NorthernWidget/ALog-BottleLogger2/README.md

# ALog-BottleLogger2
Arduino-based low-power field environmental data logging platform: hardware schematics and circuit board layouts
