NorthernWidget/ALog-BottleLogger2/PDF_Documents/Bottlelogger_V2_r1.xls

 | Component list |  | for imported PR99SE Designs only | <Parameter ProjectTitle not found>
 | Project: | <Parameter ProjectTitle not found> |  | PCB Assembly: | <Parameter AssemblyNr not found> | Sch. Drw. Nr: | 4415-0039
 | Project Number: | <Parameter PrjNr not found> |  | PCB Nr: | <Parameter PCBNr not found> | Sch. Rev: | 1
 | Used In: | <Parameter UsedIn not found> |  | PCB Type: | <Parameter PCBType not found> | Sch Type: | <Parameter DrawingType not found>
 | Filename: | Bottlelogger_V2.PrjPcb |  | Repl. For: | <Parameter ReplFor not found> | Build Nr: | <Parameter BuildNr not found>
 |  |  |  | PCB revision: | <Parameter PCBRev not found> | Author: | <Parameter DrawnBy not found>
 | Report Date/Time: | 2015-10-03 | 1:18:15 PM | Board Name: | <Parameter PCBName not found> | BOM Version: | <Parameter BOMVersion not found>
 | Print Date/Time: | 2015-10-14 | 7:54:47 |  |  | TPL Version: | V1.12 2015-03-09
Line | Part Designator | Schematic Part Value | Part Footprint | Part Library Reference | Vendor Part Description | Mfr. Part Number | Vendor Part Number | Part Mfr. | Vendor Name | Special Notes | Status | RoHS Status | Qty | Vendor Price | Price Mult.
1 | B1 | BR1225-1HC | BR1225/1HF2 | BATTERY | BATTERY LITH 12.5MM COIN W/LEGS | BR1225-1HC | P191-ND |  | DK |  |  | OK | 1 | 1.78 | 1
2 | C1, C2, C3A, C3B, C3C, C6, C9, C19, C22, C23, C24, C25, C27, C28, C30 | 0u1 | 0805N2 | CAPACITOR_N2_GND, CAPACITOR_N2_GND, CAPACITOR_N2_GND, CAPACITOR_N2_GND, CAPACITOR_N2_GND, CAPACITOR_N2_S, CAPACITOR_N2_S_GND, CAPACITOR_N2_GND, CAPACITOR_N2_GND, CAPACITOR_N2_GND, CAPACITOR_N2_GND, CAPACITOR_N2_GND, CAPACITOR_N2_GND, CAPACITOR_N2, CAPACITOR_N2_S_GND | CAP CER 0.1UF 50V 10% X7R 0805 | C0805C104K5RACTU | 399-1170-1-ND |  | DK |  |  | OK | 15 | 0.035 | 50
3 | C3 | 3n3 | 0805N2 | CAPACITOR_N2_GND | CAP CER 3300PF 50V 1% NP0 0805 | GRM2165C1H332FA01J | 490-8287-1-ND |  | DK |  |  | OK | 1 | 0.51 | 1
4 | C4, C5 | 2u2 | 0805N2 | CAPACITOR_N2_GND | CAP CER 2.2UF 10V 10% X7R 0805 | LMK212B7225KG-T | 587-1286-1-ND |  | DK |  |  | OK | 2 | 0.21 | 1
5 | C7, C8 | 18pF | 0805N2 | CAPACITOR_N2_GND | CAP CER 18PF 50V 5% NP0 0805 | 500R15N180JV4T | 709-1171-1-ND |  | DK |  |  | OK | 2 | 0.13 | 1
6 | C10 | 10uF | RB.1/.2 | CAPACITOR POL_N2_GND | CAP ALUM 10UF 20% 16V RADIAL | EEA-GA1C100H | P15787CT-ND |  | DK |  |  | OK | 1 | 0.47 | 1
7 | C11, C12 | 1uF | 0805N2 | CAPACITOR_N2_GND | CAP CER 1UF 10V X7R 0805 | 0805ZC105KAT2A | 478-1405-1-ND |  | DK |  |  | OK | 2 | 0.08 | 10
8 | C13, C14, C15, C16, C17, C18, C21, C29 | 10n | 0805N2 | CAPACITOR_N2_GND, CAPACITOR_N2_GND, CAPACITOR_N2_GND, CAPACITOR_N2_GND, CAPACITOR_N2_GND, CAPACITOR_N2_GND, CAPACITOR_N2_S_GND, CAPACITOR_N2 | CAP CER 10000PF 50V 10% X7R 0805 | GRM216R71H103KA01D | 490-1664-1-ND |  | DK |  |  | OK | 8 | 0.023, 0.023, 0.023, 0.023, 0.023, 0.023, 0.035, 0.023 | 50
9 | C20 | 4u7, 10V, T | 3216 | CAPACITOR POL_N2_GND | CAP TANT 4.7UF 10V 10% 1206 | T491A475K010AT | 399-3696-1-ND |  | DK |  |  | OK | 1 | 0.46 | 1
10 | C26 | 4u7, T | 3216 | CAPACITOR POL_N2 | CAP TANTALUM 4.7UF 6.3V 10% SMD | B45196H1475K109 | 495-2177-1-ND |  | DK |  |  | OK | 1
11 | D1 | SF1 | LED-1206 | LED_SMD_GRN | LED GREEN CLEAR 1206 SMD | LTST-C150KGKT | 160-1404-1-ND |  | DK |  |  | OK | 1 | 0.52 | 1
12 | D2 | TX | LED-1206 | LED_SMD_RED | LED RED CLEAR 1206 SMD | LTST-C150CKT | 160-1167-1-ND |  | DK |  |  | OK | 1 | 0.52 | 1
13 | D3 | RX | LED-1206 | LED_SMD_YEL | LED RED ORANGE CLEAR 1206 SMD | LTST-C150EKT | 160-1168-6-ND |  | DK |  |  | OK | 1 | 0.48 | 1
14 | D4, D6, D7 | BAT54C-7-F | SOT-23 | BAV74-SOT-23 | DIODE ARRAY SCHOTTKY 30V SOT23-3 | BAT54C-7-F | BAT54C-FDICT-ND |  | DK |  |  | OK | 3 | 0.27 | 1
15 | D5 | TZ5.6V | SMB-DIODE | DIODE ZENER_GND_N2 | DIODE ZENER 3W 5.6V SMB | 1SMB5919BT3G | 1SMB5919BT3GOSCT-ND |  | DK |  |  | OK | 1
16 | F1 | microSMD050 | 1210N2 | VARISTOR | POLYSWITCH 0.50A RESET FUSE SMD | MICROSMD050F-2 | MICROSMD050FCT-ND |  | DK |  |  | OK | 1 | 0.575 | 10
17 | F2 | MINIASMDC020F-2 | 1812R2 | VARISTOR | POLYSWITCH 0.20A RESET FUSE SMD | MINIASMDC020F-2 | MINIASMDC020F-2CT-ND |  | DK |  |  | OK | 1 | 0.57500 | 10
18 | FB1 | TBD | 1206N2 | FERRITE BEAD |  |  |  |  |  |  |  |  | 1
19 | H1, H2 | CON8 | MOLEX-6373-8 | CON8 | CONN TERM BLOCK 2.54MM 8POS PCB | OSTVN08A150 | ED10566-ND |  | DK |  |  | OK | 2 | 2.63 | 1
20 | H3 | CON4 | MOLEX-6373-4 | CON4 | CONN TERM BLOCK 2.54MM 4POS PCB | OSTVN04A150 | ED10563-ND |  | DK |  |  | OK | 1 | 1.41 | 1
21 | J1 | 61729-0010BLF | USB-B RECEPTICAL | USB-B JACK_FCI_61729-0010BLF | Connector Receptacle USB TypeB | 61729-0010BLF | 609-1039-ND |  | DK |  |  | OK | 1 | 1.23 | 1
22 | J2 | PJ-102A | PCOAX-PJ-102A | DC-JACK | CONN JACK POWER 2.1MM PCB | PJ-102A | CP-102A-ND |  | DK |  |  | OK | 1 | 1.34 | 1
23 | J2B | 1727010 | MKDS-2-3.81 | CON2 | TERM BLOCK 2POS 3.81MM PCB GRN | 1727010 | 277-1947-ND |  | DK |  |  | OK | 1 | 1.50 | 1
24 | J3 | 22-28-4043 | MOLEX-6373-4 | CON4 | CONN HEADER 4POS .100 VERT GOLD | 22-28-4043 | WM6504-ND |  | DK |  |  | OK | 1
25 | J4 | OSTVN03A150 | MOLEX-6373-3 | CON3 | CONN TERM BLOCK 2.54MM 3POS PCB | OSTVN03A150 | ED10562-ND |  | DK |  |  | OK | 1 | 1.06 | 1
26 | J5 | CON6 | MOLEX-6373-6 | CON6 | CONN TERM BLOCK 2.54MM 6POS PCB | OSTVN06A150 | ED10565-ND |  | DK |  |  | OK | 1 | 1.97 | 1
27 | J6 | PPPC061LFBN-RC | HEADER-6X1 | CON6 | Connector Header 6 Position 0.100 | PPPC061LFBN-RC | S7039-ND |  | DK |  |  | OK | 1 | 0.94 | 1
28 | J7 | CON2 | HEADER-2X1 | CON2 | CONN HEADER 2POS .100" SGL GOLD | TSW-102-07-L-S | SAM1031-02-ND |  | DK |  |  | OK | 1 | 0.95 | 1
29 | JP1 | ISP | HEADER-8X2 | HEADER 8X2 | CONN HEADER 16POS .100" DL GOLD | TSW-108-07-L-D | SAM1030-08-ND |  | DK |  |  | OK | 1 | 2.86 | 1
30 | JP2, JP3 | HEADER 4X2 | HEADER-4X2 | HEADER 4X2 |  |  |  |  |  |  |  |  | 2
31 | JP4 | HEADER 5X2 | HEADER-5X2 | HEADER 5X2 | CONN HEADER 10POS .100" DL GOLD | TSW-105-07-L-D | SAM1030-05-ND |  | DK |  |  | OK | 1 | 2.37 | 1
32 | JP5 | VBE | HEADER-2X1 | HEADER 2L | CONN HEADER 2POS .100" SGL GOLD | TSW-102-07-L-S | SAM1031-02-ND |  | DK |  |  | OK | 1 | 0.95 | 1
33 | JP6 | TSW-102-07-L-S | HEADER-2X1 | HEADER 2L | CONN HEADER 2POS .100" SGL GOLD | TSW-102-07-L-S | SAM1031-02-ND |  | DK |  |  | OK | 1 | 0.95 | 1
34 | LOGO1 | ALOG LOGO | ALOG_LOGO_V1_SMALL | BARCODE_DY_10MM | BAR CODE FIELD - NOT A PART | N/A | N/A |  | N/A |  | DNP | N/A | 1 | N/A | N/A
35 | LOGO2 | NORTHERN WIDGET LOGO | NWLOGO | BARCODE_DY_10MM | BAR CODE FIELD - NOT A PART | N/A | N/A |  | N/A |  | DNP | N/A | 1 | N/A | N/A
36 | OSHW1 | OSHW_FILLX200 | OSHW_FILLX200_NOTEXT_N1 | BARCODE_DY_10MM | BAR CODE FIELD - NOT A PART | N/A | N/A |  | N/A |  | DNP | N/A | 1 | N/A | N/A
37 | Q1, Q2, Q5 | FDN360P | SOT-23 | MOSF-P-SOT-23_R1 | MOSFET P-CH 30V 2A SSOT3 | FDN360P | FDN360PCT-ND |  | DK |  |  | OK | 3 | 0.6020 | 10
38 | Q3, Q4 | BSS138 | SOT-23 | MOSF-N-SOT-23 | MOSFET N-CH 50V 200MA SOT23-3 | BSS138-7-F | BSS138-FDICT-ND |  | DK |  |  | OK | 2 | 0.47 | 1
39 | R1, R2, R3, R4, R5, R6, R19, R20, R21, R22, R23, R24, R30, R31 | 10K0 | 0805N2 | WID_SHRT_GND, WID_SHRT_GND, WID_SHRT_GND, WID_SHRT_GND, WID_SHRT_GND, WID_SHRT_GND, WID_SHRT, WID_SHRT, WID_SHRT, WID_SHRT, WID_SHRT, WID_SHRT, WID_SHRT, WID_SHRT_GND | RES SMD 10K OHM 1% 1/8W 0805 | ERJ-6ENF1002V | P10.0KCCT-ND |  | DK |  |  | OK | 14 | 0.14 | 1
40 | R7, R8, R26, R27, R34 | 3K | 0805N2 | WID_SHRT | RES SMD 3K OHM 5% 1/8W 0805 | RC0805JR-073KL | 311-3.0KARCT-ND |  | DK |  |  | OK | 5 | 0.14 | 1
41 | R9, R12, R13, R43, R44, R49 | 1K | 0805N2 | WID_SHRT | RES SMD 1K OHM 5% 1/8W 0805 | RC0805JR-071KL | 311-1.0KARCT-ND |  | DK |  |  | OK | 6 | 0.14 | 1
42 | R10, R11, R17, R18, R33, R42, R51, R55, R56, R57 | 330R | 0805N2 | WID_SHRT | RES SMD 330 OHM 5% 1/8W 0805 | RC0805JR-07330RL | 311-330ARCT-ND |  | DK |  |  | OK | 10 | 0.14 | 1
43 | R14, R25, R48 | 10K | 0805N2 | WID_SHRT | RES SMD 10K OHM 5% 1/8W 0805 | RC0805JR-0710KL | 311-10KARCT-ND |  | DK |  |  | OK | 3 | 0.14 | 1
44 | R15, R53 | 220R | 0805N2 | WID_SHRT | RES SMD 220 OHM 5% 1/8W 0805 | RC0805JR-07220RL | 311-220ARCT-ND |  | DK |  |  | OK | 2 | 0.14 | 1
45 | R16 | 470K | 0805N2 | WID_SHRT | RES SMD 470K OHM 5% 1/8W 0805 | RC0805JR-07470KL | 311-470KARCT-ND |  | DK |  |  | OK | 1 | 0.14 | 1
46 | R28, R37, R38, R39, R41, R47 | 100K | 0805N2 | WIDERSTAND, WIDERSTAND, WIDERSTAND, WID_SHRT_GND, WID_SHRT_GND, WID_SHRT | RES SMD 100K OHM 5% 1/8W 0805 | ERJ-6GEYJ104V | P100KACT-ND |  | DK |  |  | OK | 6 | 0.14 | 1
47 | R29, R45 | 100R | 0805N2 | WIDERSTAND | RES 100 OHM 1/8W 5% 0805 SMD | ERJ-6GEYJ101V | P100ACT-ND |  | DK |  |  | OK | 2 | 0.14 | 1
48 | R32, R50 | 10R | 0805N2 | WID_SHRT | RES SMD 10 OHM 5% 0.4W 0805 | ESR10EZPJ100 | RHM10KCT-ND |  | DK |  |  | OK | 2 | 0.14 | 1
49 | R35 | 510R, 1W | 2512R2 | WID_SHRT | RES SMD 510 OHM 5% 1W 2512 | RMCF2512JT510R | RMCF2512JT510RCT-ND |  | DK |  |  | OK | 1 | 0.63 | 1
50 | R36 | 200K | 0805N2 | WID_SHRT_GND | RES SMD 200K OHM 5% 1/8W 0805 | RC0805JR-07200KL | 311-200KARCT-ND |  | DK |  |  | OK | 1 | 0.14 | 1
51 | R40 | 510R | 0805N2 | WID_SHRT | RES SMD 510 OHM 5% 1/8W 0805 | RC0805JR-07510RL | 311-510ARCT-ND |  | DK |  |  | OK | 1 | 0.14 | 1
52 | R46 | 120R | 0805N2 | WID_SHRT | RES SMD 120 OHM 5% 1/8W 0805 | RC0805JR-07120RL | 311-120ARCT-ND |  | DK |  |  | OK | 1 | 0.14 | 1
53 | R52 | 3K(DNP) | 0805N2 | WID_SHRT | RES SMD 3K OHM 5% 1/8W 0805 | RC0805JR-073KL | 311-3.0KARCT-ND |  | DK |  |  | OK | 1 | 0.14 | 1
54 | R54 | 4K7 | 0805N2 | WID_SHRT | RES SMD 4.7K OHM 5% 1/8W 0805 | ERJ-6GEYJ472V | P4.7KACT-ND |  | DK |  |  | OK | 1 | 0.14 | 1
55 | SD1 | 2041021-4 | TE_2041021-4_SDCARD | 3M_SD-RSMT-2-MQ-WF_N2 | CONN SD CARD PUSH-PULL R/A SMD | 2041021-4 | A101492CT-ND |  | DK |  |  | OK | 1 | 4.16 | 1
56 | SG1 | 2051-09-SM-RPLF | 1812 | SPARKGAP | GDT 90V 30% 2KA SURFACE MOUNT | 2051-09-SM-RPLF | 2051-09-SM-RPLFCT-ND |  | DK |  |  | OK | 1 | 1.10 | 1
57 | SN1 | SER. NUM. | STATIC-0.25" | BARCODE_DY_10MM | BAR CODE FIELD - NOT A PART | N/A | N/A |  | N/A |  | DNP | N/A | 1 | N/A | N/A
58 | SP1 | VREF SEL | SOLDERPAD-2WAY | SOLDER-PAD 2WAY |  |  |  |  |  |  |  |  | 1
59 | SW1 | MAN LOG | SWITCH_EVQPE1_PANASONIC | SW PUSHBUTTON | SWITCH TACTILE SPST-NO 0.05A 12V | EVQ-PE104K | P13593SCT-ND |  | DK |  |  | OK | 1 | 1.03 | 1
60 | SW2 | RESET | SWITCH_EVQPE1_PANASONIC | SW PUSHBUTTON | SWITCH TACTILE SPST-NO 0.05A 12V | EVQ-PE104K | P13593SCT-ND |  | DK |  |  | OK | 1 | 1.03 | 1
61 | TP1 | 32KHZ | TESTPOINT-2 | TESTPOINT | PCB Primitive - Not a part | N/A | N/A |  | N/A |  |  | N/A | 1 | N/A | N/A
62 | TP2 | 3.3V | TESTPOINT-2 | TESTPOINT | PCB Primitive - Not a part | N/A | N/A |  | N/A |  |  | N/A | 1 | N/A | N/A
63 | TP3 | VUSB | TESTPOINT-2 | TESTPOINT | PCB Primitive - Not a part | N/A | N/A |  | N/A |  |  | N/A | 1 | N/A | N/A
64 | TP4 | CSD | TESTPOINT-2 | TESTPOINT | PCB Primitive - Not a part | N/A | N/A |  | N/A |  |  | N/A | 1 | N/A | N/A
65 | TVS1 | USBLC6-2 | SOT-23-6 | USBLC6-2 | IC ESD PROTECTION FOR HS SOT-23-6 | USBLC6-2SC6Y | 497-11882-1-ND |  | DK | DNP |  | OK | 1 | 1.046 | 10
66 | TVS2, TVS3 | MMBZ5V6ALT1 | SOT-23 | MMBZ5V6ALT1G | TVS ZENER DUAL 24W CA 5.6V SOT23 | MMBZ5V6ALT1G | MMBZ5V6ALT1GOSCT-ND |  | DK |  |  | OK | 2 | , 0.32
67 | U1 | ATMEGA1284P-AUR | TQFP-44-10X10X1_0.8_SOT376-1 | ATMEGA1284P_TQFP | IC MCU 8BIT 128KB FLASH 44TQFP | ATMEGA1284P-AUR | ATMEGA1284P-AURCT-ND |  | DK |  |  | OK | 1 | 11.50 | 1
68 | U2, U3 | LP2985-33DBVR | SOT-23-5 | LP2985 | IC REG LDO 3.3V 0.15A SOT23-5 | LP2985-33DBVR | 296-18476-1-ND |  | DK |  |  | OK | 2 | 0.8 | 1
69 | U4 | CD4050BPWR | TSSOP-16R2_4.5MM | MC14050B_N1 | IC BUFF/CONVERTER HEX 16TSSOP | CD4050BPWR | 296-31504-1-ND |  | DK |  |  | OK | 1 | 0.59 | 1
70 | U5 | FT232RL | SSOP-28 | FT232RL_M2_R1 | IC USB FS SERIAL UART 28-SSOP | FT232RL-REEL | 768-1007-1-ND |  | DK |  |  | OK | 1 | 6.03 | 1
71 | U6 | DS3231 | SOL-16R2 | DS3231 | IC RTC CLK/CALENDAR I2C 16-SOIC | DS3231SN#T&R | DS3231SN#T&RCT-ND |  | DK |  |  | OK | 1 | 13.37 | 1
72 | U7 | LTC4412 | SOT-23-6 | LTC4412 | IC OR CTRLR SRC SELECT TSOT23-6 | LTC4412ES6#TRMPBF | LTC4412ES6#TRMPBFCT-ND |  | DK |  |  | OK | 1 | 4.26 | 1
73 | U8 | SN74LVC1G125DBVR | SOT-23-5 | 74LVC1G125 | IC BUS BUFF TRI-ST N-INV SOT23-5 | SN74LVC1G125DBVR | 296-11603-1-ND |  | DK |  |  | OK | 1 | 0.52 | 1
74 | U9, U10 | SN74AHC1G14DBVR | SOT-23-5 | SN74AHC1G14 | IC SCHMITT-TRG INV GATE SOT23-5 | SN74AHC1G14DBVR | 296-1092-1-ND |  | DK |  |  | OK | 2 | 0.66 | 1
75 | U11 | SN74LVC1G126DBVR | SOT-23-5 | 74LVC1G126N1 | IC BUS BUFF TRI-ST N-INV SOT23-5 | SN74LVC1G126DBVR | 296-11605-1-ND |  | DK |  |  | OK | 1 | 0.52 | 1
76 | U12 | LTC1482CS8 | SO-8 | LTC1482_SM | IC TXRX RS485 LOWPWR 8-SOIC | LTC1482CS8#PBF | LTC1482CS8#PBF-ND |  | DK |  |  | OK | 1 | 4.46 | 1
77 | U14 | TMP101 | SOT-23-6 | TMP101 | IC TEMP SENSOR DIGITAL SOT-23-6 | TMP101NA/250 | 296-12750-1-ND |  | DK |  |  | OK | 1 | 3.66 | 100
78 | U15 | LTC1669 | MSOP-8 | LTC1669_MSOP-8 | IC DAC 10BIT R-R I2C 8-MSOP | LTC1669CMS8#PBF | LTC1669CMS8#PBF-ND |  | DK |  |  | OK | 1 | 4.72 | 1
79 | U16, U21 | SN74LVC1G08DBVR | SOT-23-5 | 74LVC1G08 | IC GATE AND 1CH 2-INP SOT-23-5 | SN74LVC1G08DBVR | 296-11601-1-ND |  | DK |  |  | OK | 2 | 0.66 | 1
80 | U17, U23 | SN74LVC1G3157 | SOT-23-6 | SN74LVC1G3157 | IC SWITCH SPDT SOT23-6 | SN74LVC1G3157DBVR | 296-14908-1-ND |  | DK |  |  | OK | 2 | 0.52 | 1
81 | U18 | LM4132AMF-3.0/NOPB | SOT-23-5 | LM4130-SOT23-5 | IC VREF SERIES 3V SOT23-5 | LM4132AMF-3.0/NOPB | LM4132AMF-3.0/NOPBCT-ND |  | DK |  |  | OK | 1 | 4.38 | 1
82 | U19 | M24M02-DRMN6TP | SO-8 | AT24C1024 | IC EEPROM 2MBIT 1MHZ 8SO | M24M02-DRMN6TP | 497-11600-1-ND |  | DK |  |  | OK | 1 | 6.26 | 1
83 | U20, U22 | 74LVC4066PW,118 | TSSOP-14N2 | MM74HC4016 | IC SWITCH QUAD SPST 14TSSOP | 74LVC4066PW,118 | 568-9989-1-ND |  | DK |  |  | OK | 2 | 1.11 | 1
84 | Y1 | 16MHZ | CM309S | CTS-XTAL_N2 | Crystals 16MHz 18pF PLASTIC SMD | CM309E-16.000MABJ-UT | 695-CM309E-16-U | ? | Mouser |  |  | OK | 1 | 1.23 | 1
85 | ZD1 | SMAJ4737A-TP | SMA-DIODE | DIODE ZENER | DIODE ZENER 7.5V 1W DO214AC | SMAJ4737A-TP | SMAJ4737A-TPMSCT-ND |  | DK |  |  | OK | 1 | 0.66 | 1
86
