NorthernWidget/ALog-BottleLogger2/PDF_Documents/BL1284P_Schematics.pdf

1 | 2 | 3 | 4 | 5 | 6

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
Unless otherwise specified, all values are as follows: resistor values are in Ohms, i.e. 0R47, 5R6, 220, 5K6, 22K capacitor values are in Microfarads, i.e. 220p, 0u1, 2u2, 33 inductor values are in Microhenries, i.e. 0u22, 5u6, 68, 2m2

The ALog BottleLogger 2.0 by Gerhard
Oberforcher and modified from the original
design by Andrew D. Wickert and Northern Widget LLC, is licensed under a Creative Commons Attribution-ShareAlike 3.0 Unported License

15027
ADT/GJO

# BOTTLE LOGGER V2.0.0

1 | 4415-0039

10-Nov-2015

Logger100.prj

Title

Size: | Drw. Nr

File:

Rev:

Sheet of

A3

Drw. Type: | Prj. Nr

Scale:

Date | Name
Drawn
Modified
Checked
Change | Change | Date | Name
Notification Nr. Index
PCB Nr. | 6-0039
Used in | Repl.for
Prototype | Production

PCB Name: Bottle Logger Board V2.0.0

PCB Type:

Requires TGL-017 Font

Build No.

BOM Done?

Name
Logger100PR.sch

Name
Logger100_IO.sch

x

FR4 2L 2LL 2SM 0.062 | EL | FIELD DATA LOGGING | BOTTLE LOGGER V1

PCB SCHEMATIC

1

YES

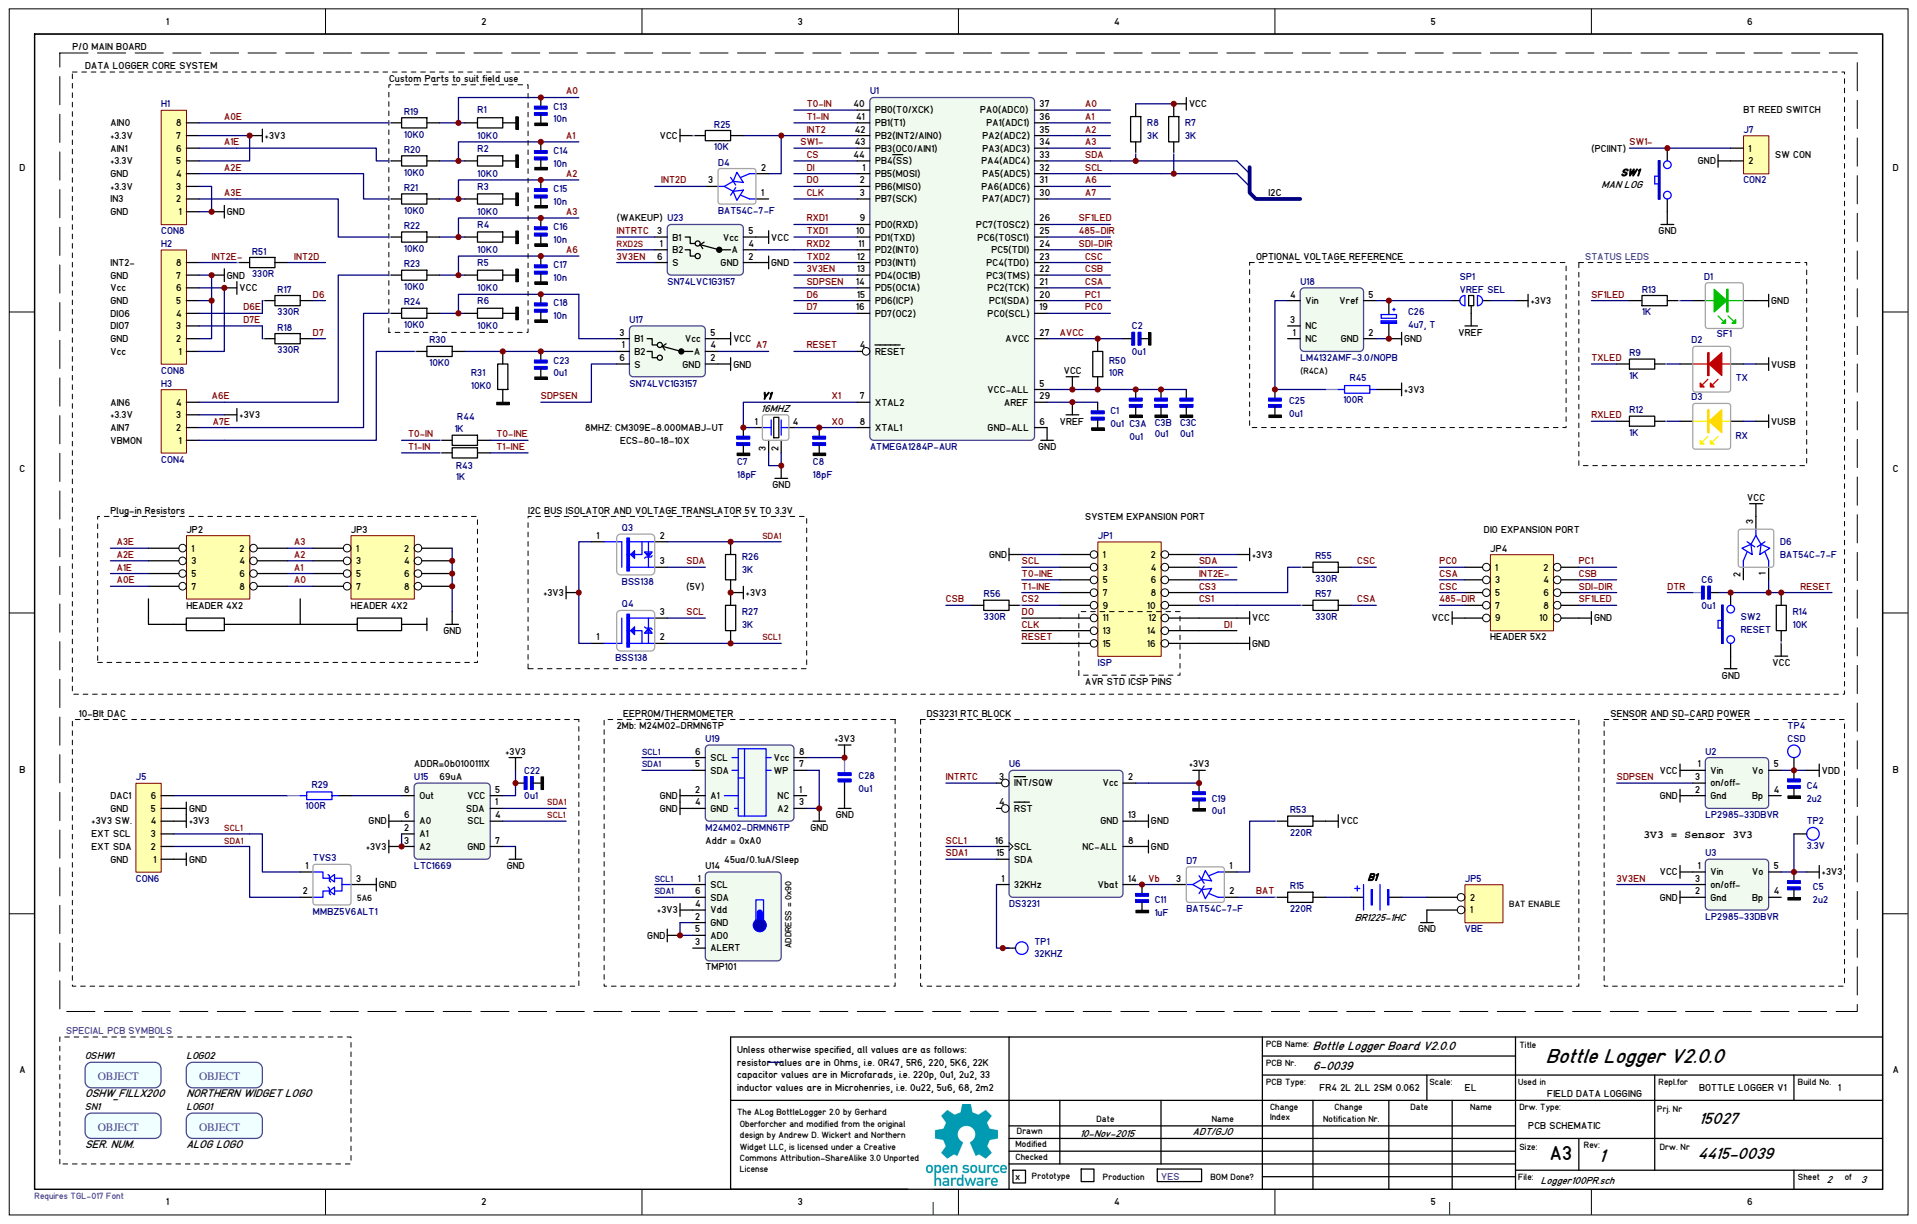
[picture p1: page 2]

P/O MAIN BOARD
DATA LOGGER CORE SYSTEM

Custom Parts to suit field use

I2C BUS ISOLATOR AND VOLTAGE TRANSLATOR 5V TO 3.3V

ISP
AVR STD ICSP PINS

SENSOR AND SD-CARD POWER

PCB Name: Bottle Logger Board V2.0.0

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

The ALog BottleLogger 2.0 by Gerhard
Oberforcher and modified from the original

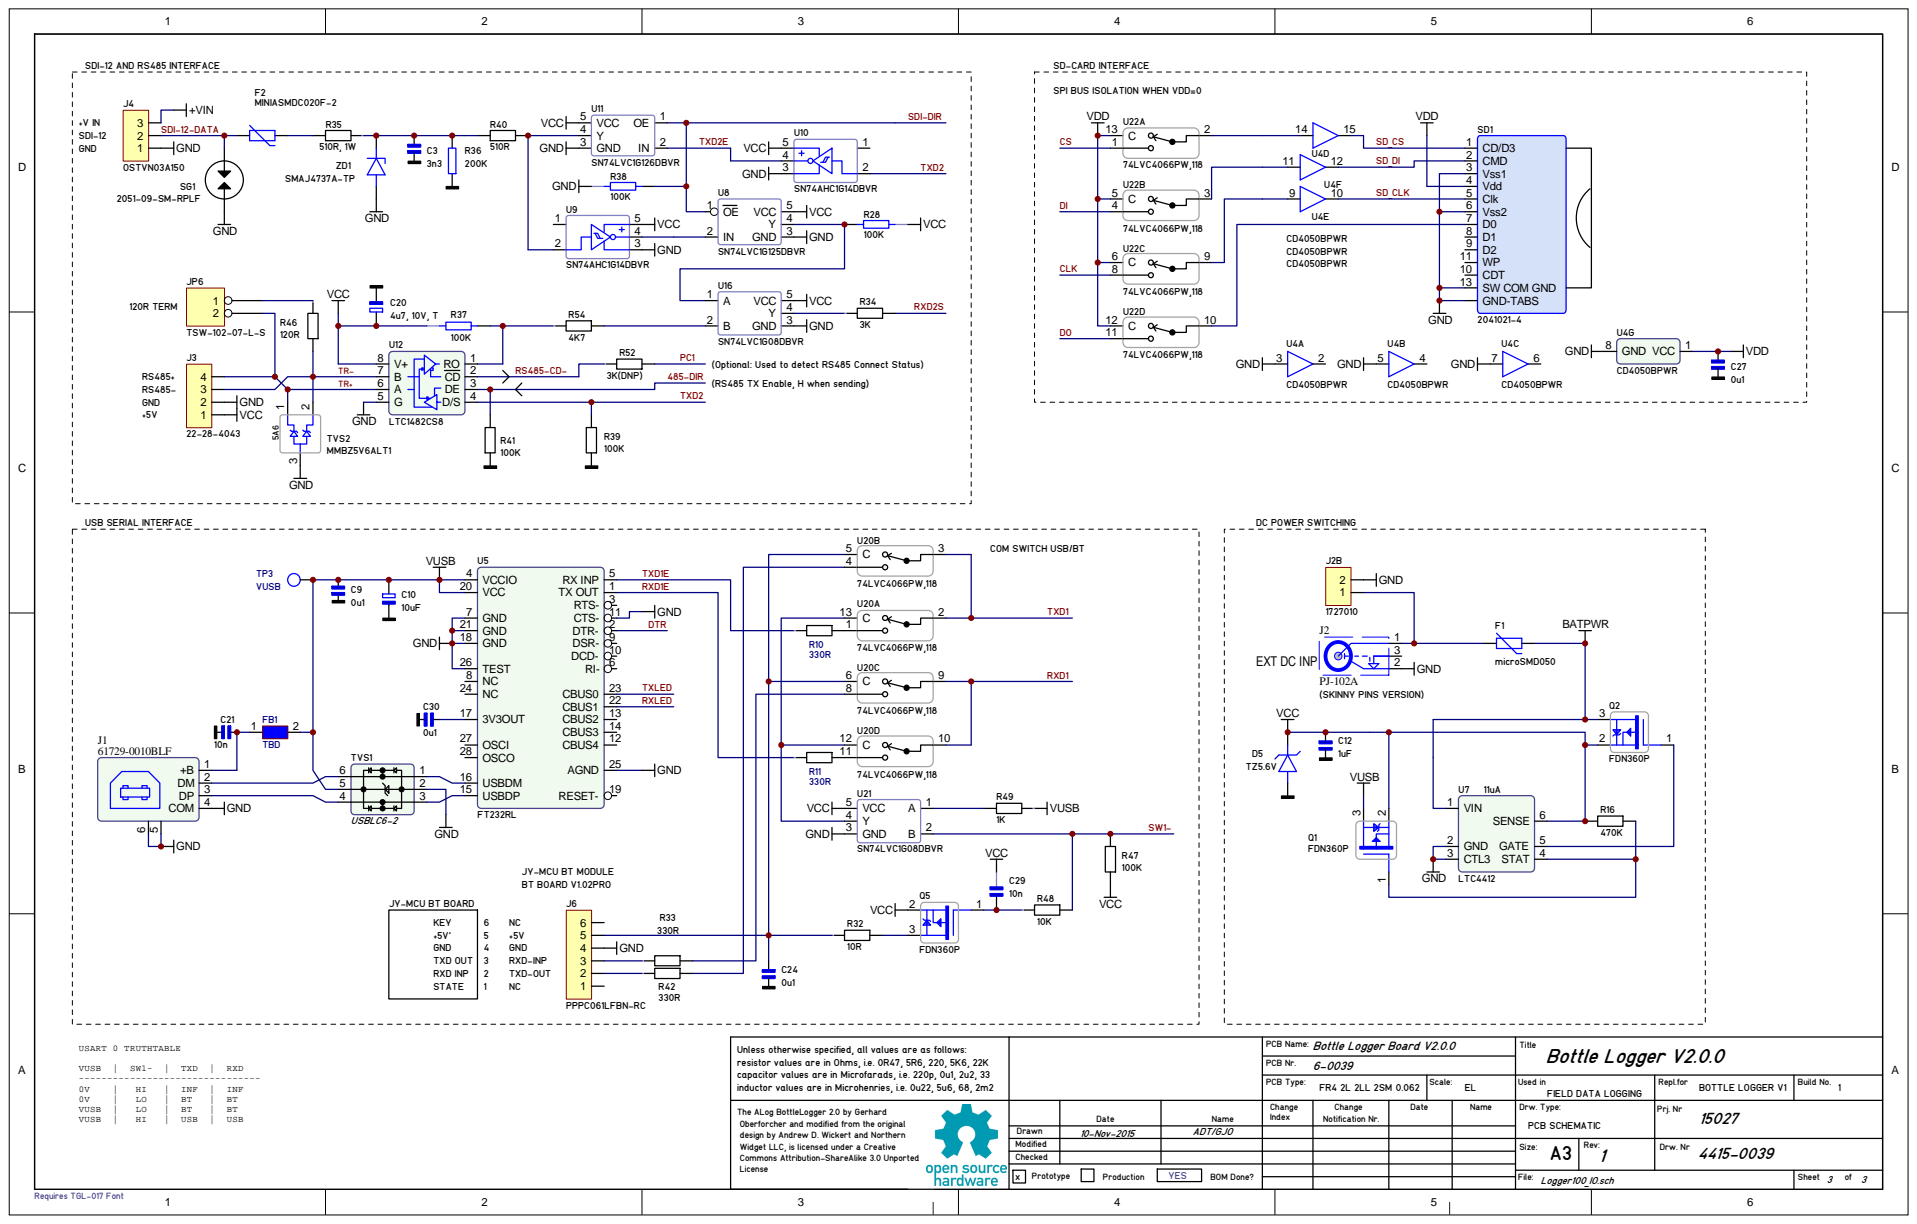
[picture p2: page 3]

COM SWITCH USB/BT

JY-MCU BT MODULE
BT BOARD V1.02PRO

JY-MCU BT BOARD

PCB Name: Bottle Logger Board V2.0.0

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

The ALog BottleLogger 2.0 by Gerhard
Oberforcher and modified from the original
