NorthernWidget/ALog-BottleLogger2/PDF_Documents/BL1284P_Bottom Assembly Drawing.pdf

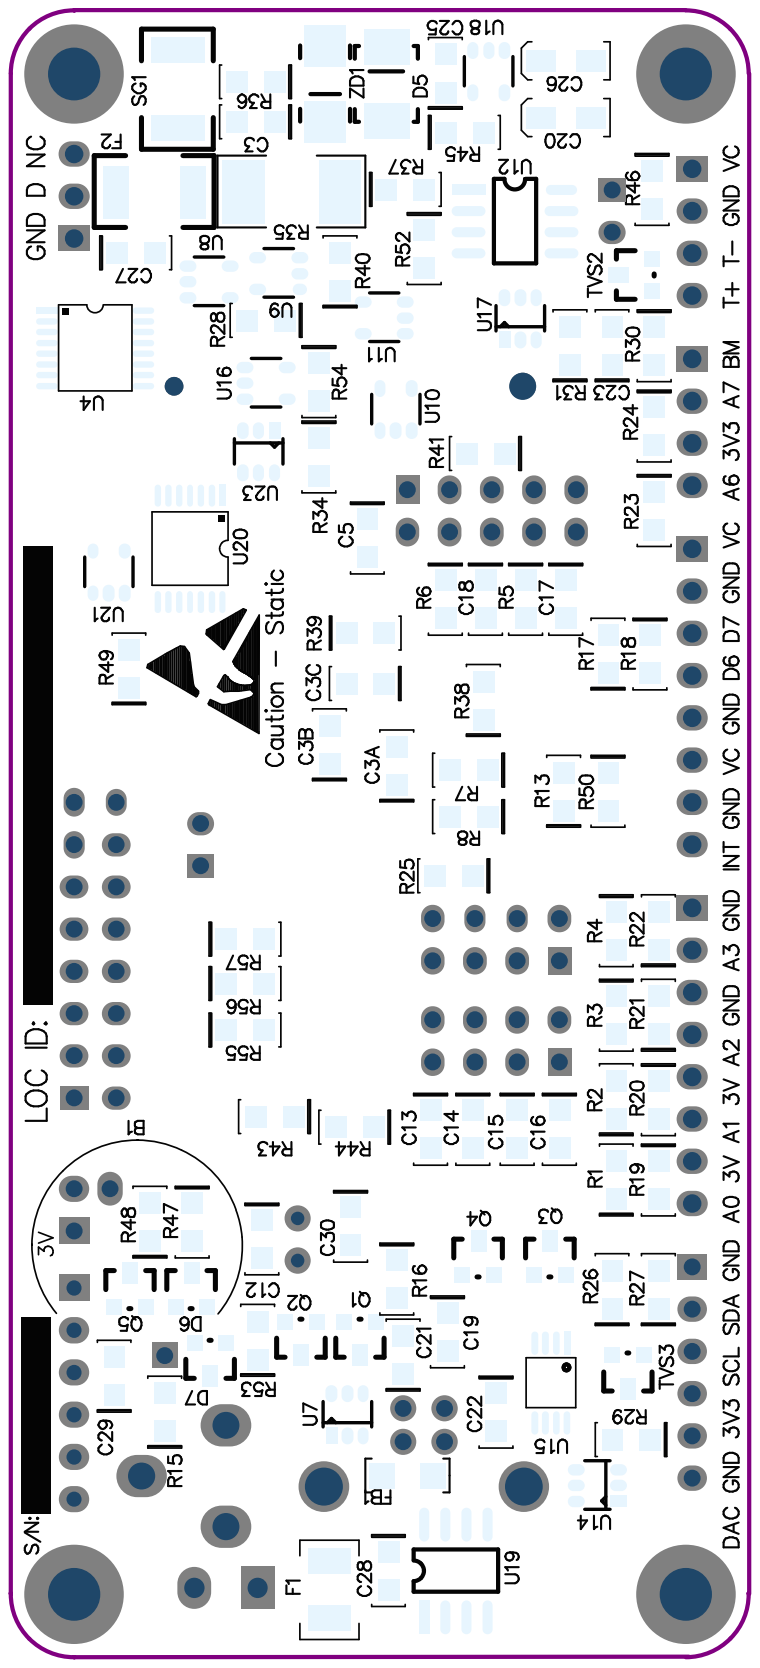
[picture p3: page 1]
