NorthernWidget/ALog-BottleLogger2/PDF_Documents/BL1284P_Top Assembly Drawing.pdf

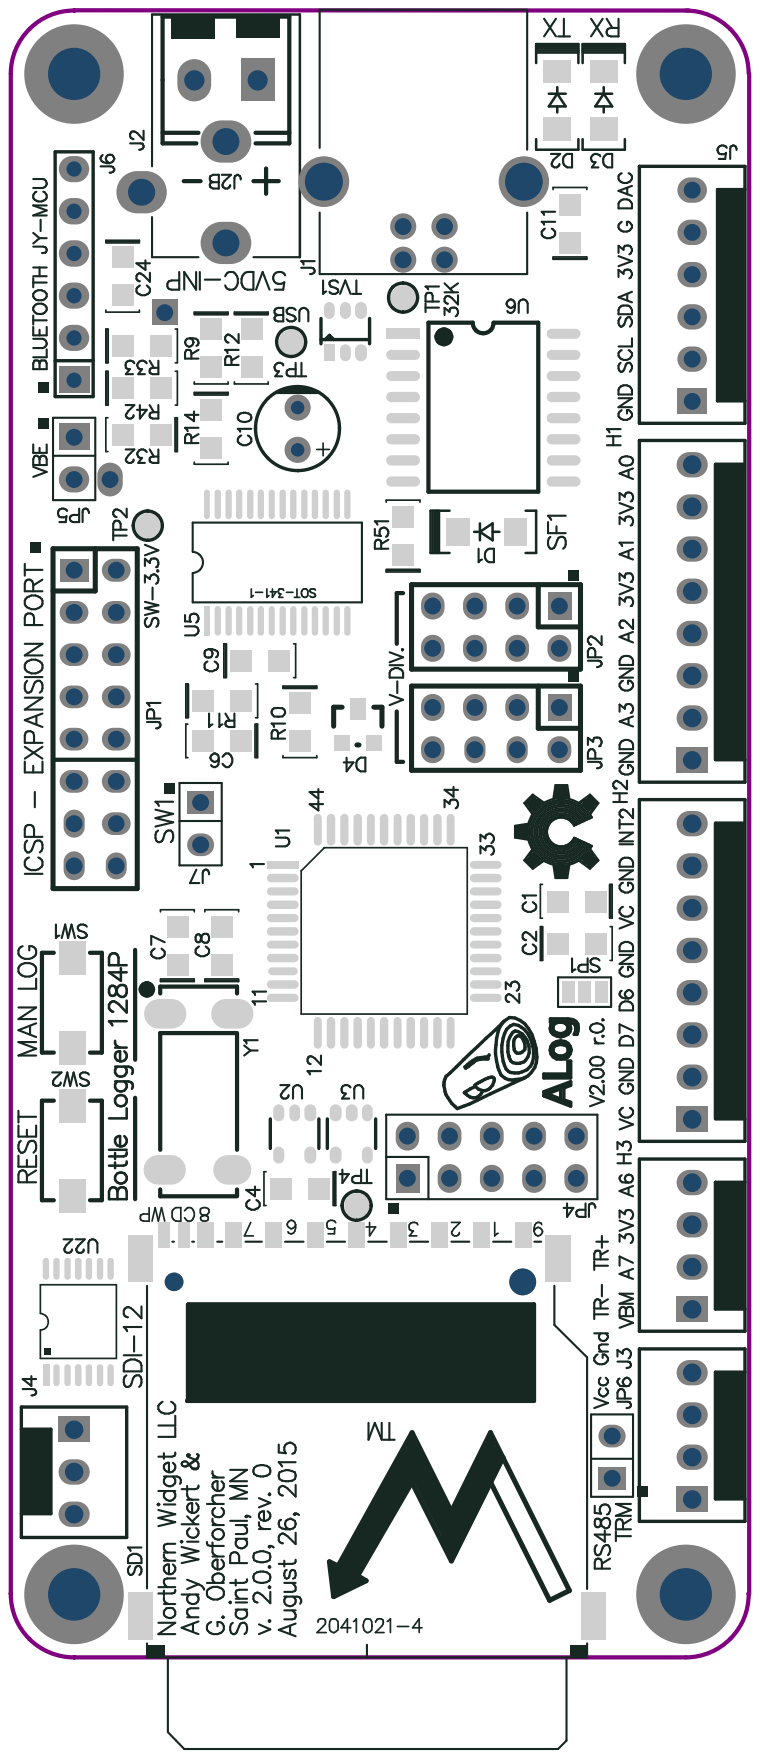
[picture p4: page 1]
