NorthernWidget/ALog-BottleLogger2/PDF_Documents/BL1284P_Composite_Layout.pdf

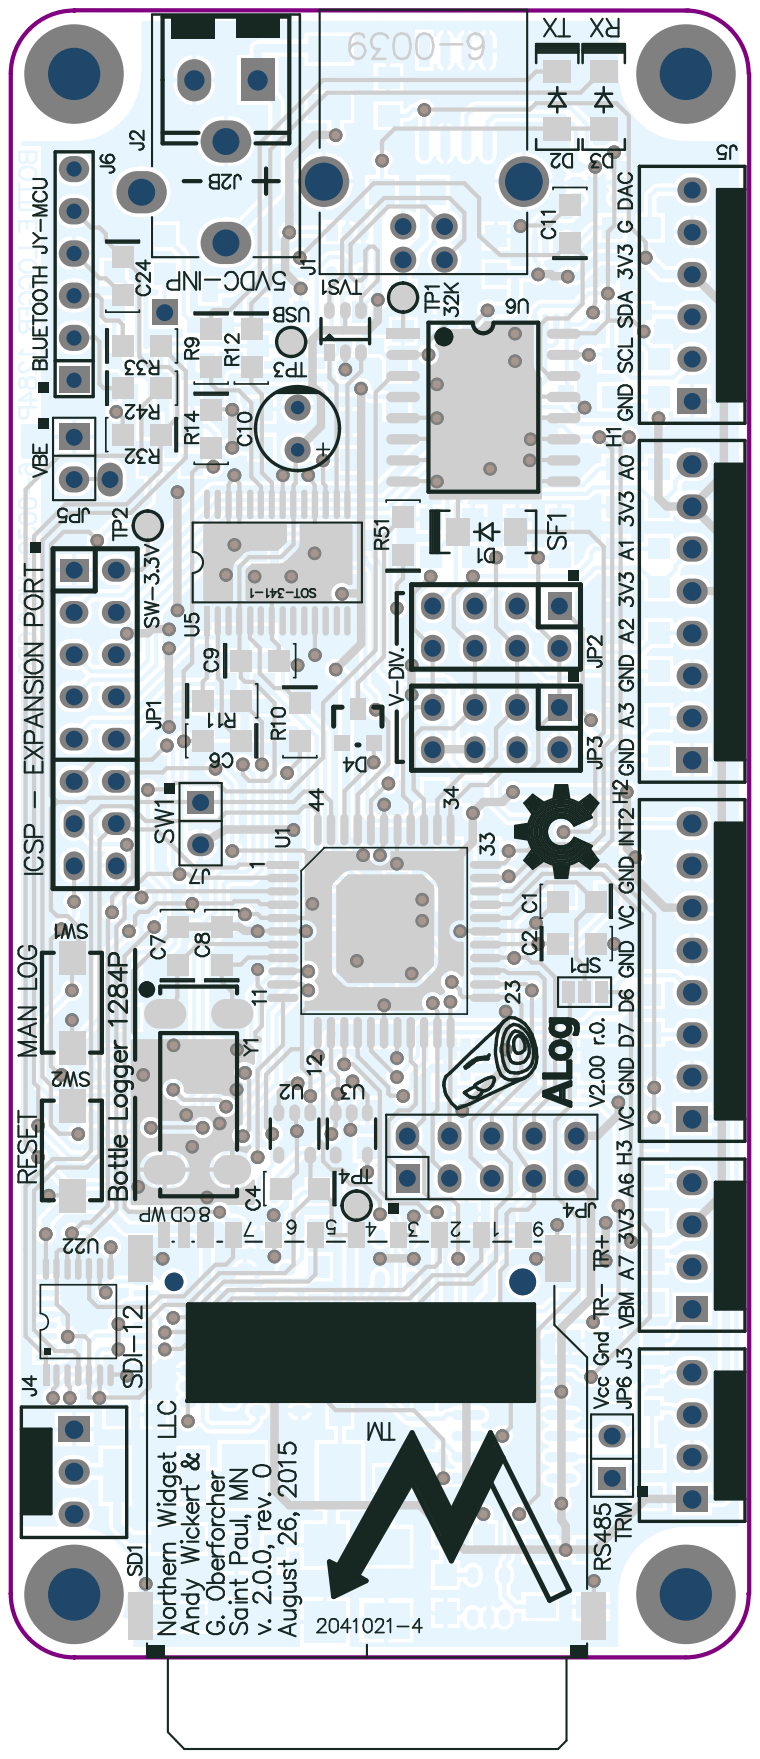
[picture p5: page 1]
