NorthernWidget/ALog-BottleLogger2/(list of files, drawings)

Other design files:
BL1284P_DataLogger_V2.00/Bottlelogger_V2/Assembly/logger100.pcb
BL1284P_DataLogger_V2.00/Bottlelogger_V2/logger100.pcb
