NorthernWidget/ALog-BottleLogger2/(commit log)

2015-11-10 First Upload of BL1284P V2.00 CAD Files
    Complete CAD file documentation package in PR99SE format. PDFs of
    schematic and assembly.
    [Logger100.cfg, Logger100PR.cfg, Logger100PR.sch, Logger100_IO.sch, Sheet1.Sch, Wiring_V2.sch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]
2015-11-10 Added spreadsheet type BOM
    BL1284P BOM
    [Bottlelogger_V2_r1.xls]
